CalciumNitride/Arabica37/README.md

# Arabica3/7

arabica3/7

A split keyboard with 3x6 column staggered keys, 1 pinkey and 3 thumb keys.

* Keyboard Maintainer: [CalciumNitride](https://github.com/CalciumNitride)
* Hardware Supported: Arabica3/7 PCB, Pro Micro
