CalciumNitride/Arabica37/firmware/arabica37/readme.md

# Arabica3/7

arabica3/7

A split keyboard with 3x6 column staggered keys, 1 pinkey and 3 thumb keys.

* Keyboard Maintainer: [CalciumNitride](https://github.com/CalciumNitride)
* Hardware Supported: Arabica3/7 PCB, Pro Micro
* Hardware Availability: [PCB & Case Data](https://github.com/calciumnitride/arabica37)

Make example for this keyboard (after setting up your build environment):

    make arabica37/rev1:default

See the [build environment setup](https://docs.qmk.fm/#/getting_started_build_tools) and the [make instructions](https://docs.qmk.fm/#/getting_started_make_guide) for more information. Brand new to QMK? Start with our [Complete Newbs Guide](https://docs.qmk.fm/#/newbs).
