CalciumNitride/Arabica37/pictures/1_diode01.png

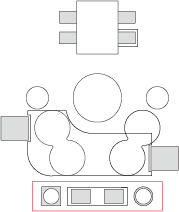
pictures/1_diode01.png
