CalciumNitride/Arabica37/pictures/2_backlightLED01.png

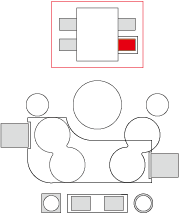
pictures/2_backlightLED01.png
