CalciumNitride/Arabica37/pictures/3_OLED01.png

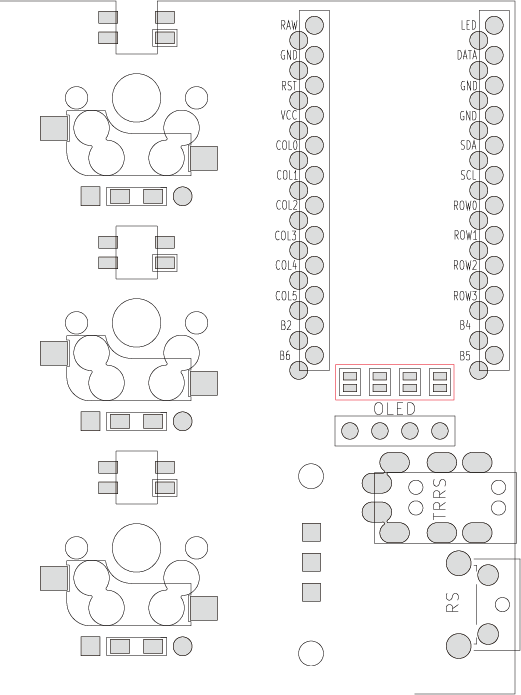
pictures/3_OLED01.png
