CalciumNitride/Arabica37/pictures/4_TRRSandRS01.png

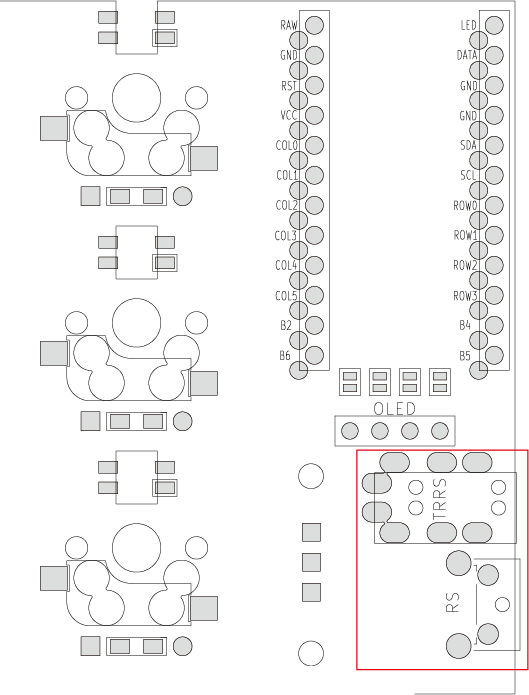
pictures/4_TRRSandRS01.png
