CalciumNitride/Arabica37/pictures/5_promicro01.png

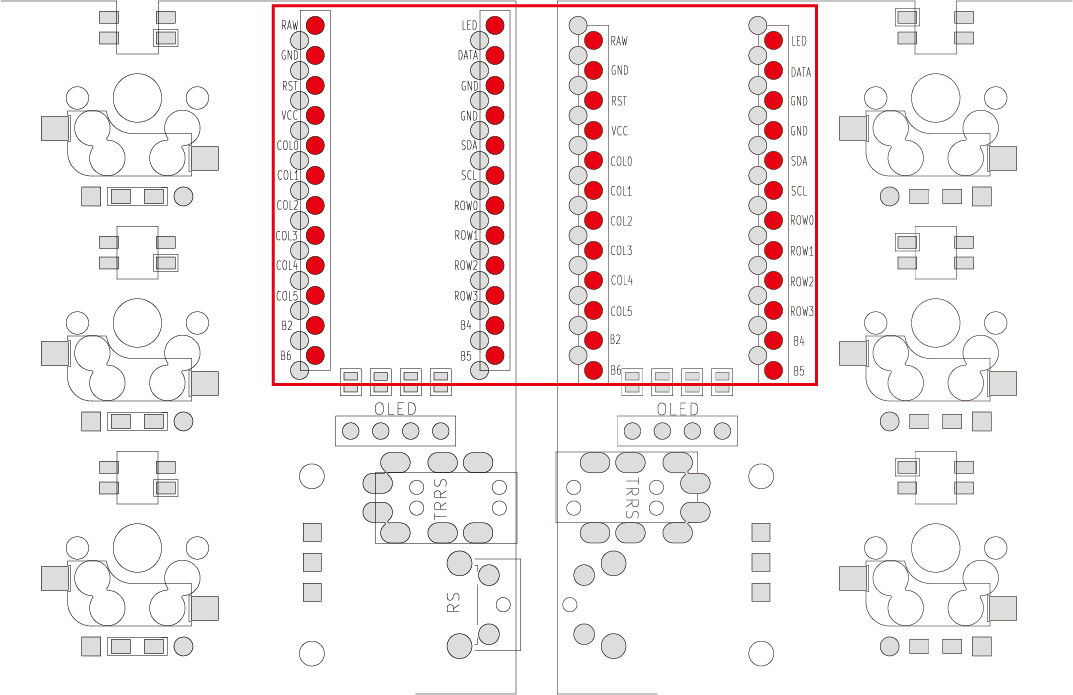
pictures/5_promicro01.png
