CalciumNitride/Arabica37/pictures/6_socket01.png

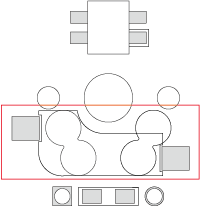
pictures/6_socket01.png
