CalciumNitride/Arabica37/pictures/8_LEDtest01.png

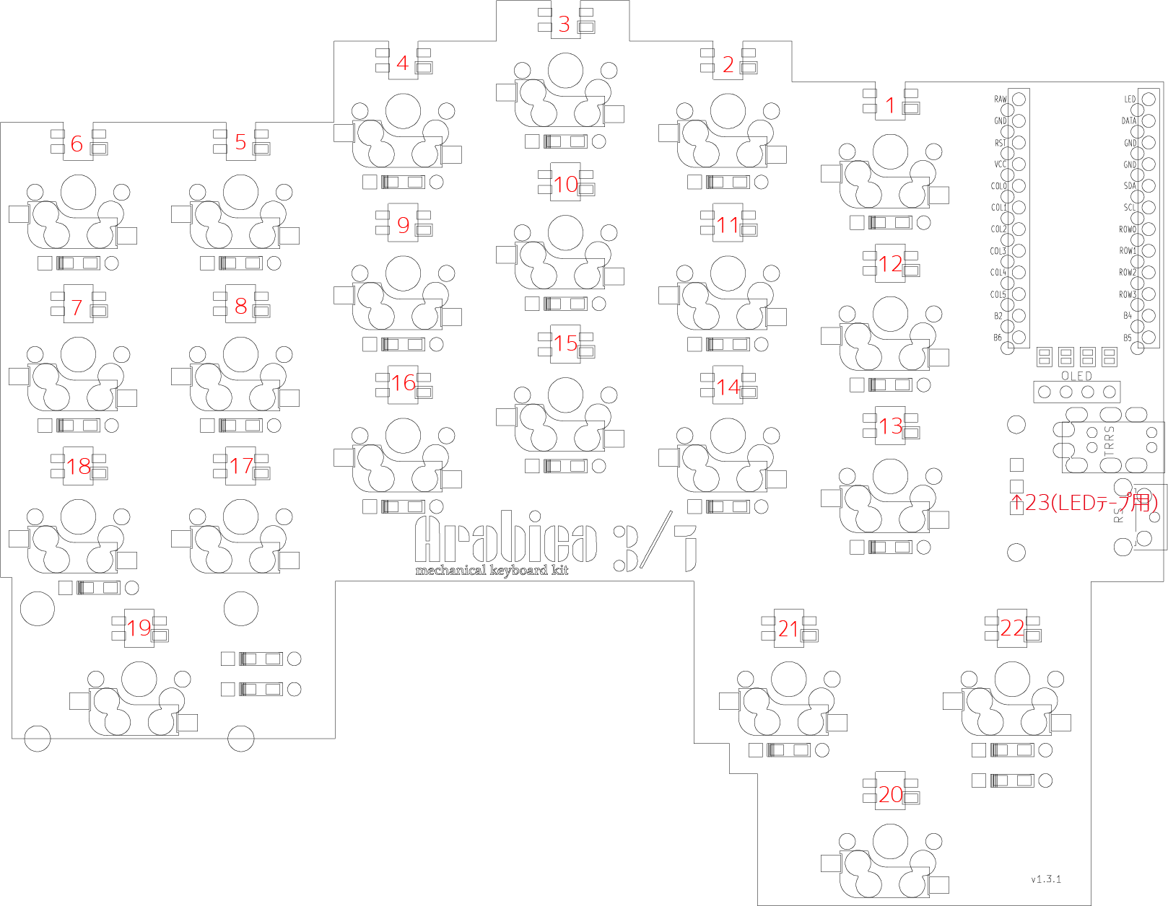
pictures/8_LEDtest01.png
