CalciumNitride/Arabica37/pictures/9_stabilizer01.png

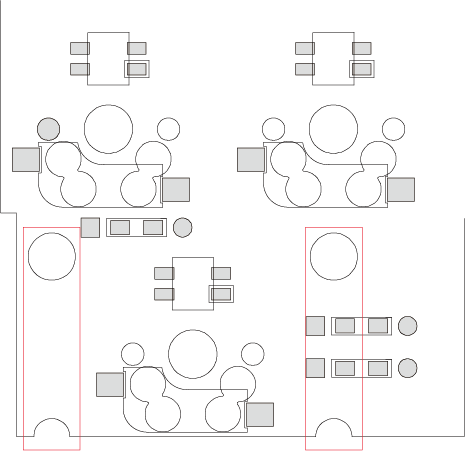
pictures/9_stabilizer01.png
