CalciumNitride/Arabica37/doc/v1.2buildguide.md

# build guide
自作キーボードキット Arabica3/7 v1.2基板のビルドガイドです。
現在遊舎工房で販売されているキットはv1.3.1ですので[こちら](https://qiita.com/CalciumNitride/items/0a86957d5b24e8304b73)をご覧ください。

## Parts

### キット内容物

名称| 数量 | 備考 |
----|----:|:----:|
PCB             |　2 | リバーシブル
スイッチプレート  | 2|"
ボトムプレート   | 2|"
Promicroカバー|2|"
TRRSジャック     |2|
タクトスイッチ    |2|リセットスイッチ用
スペーサ M2 8mm   |18|
ネジ M2          |36|
ダイオード       |44|スルーホール

### 別途用意する必要のあるもの

名称| 数量 | 備考 |
----|----:|:----:|
キースイッチ|44|MX互換
Kailh PCBソケット|44|キースイッチに合うもの
キーキャップ  |44|キースイッチに合うもの
ProMicro|2|コンスルー使用可
スタビライザー|2|小指キー用 2U
USBケーブル|1|
TRRSケーブル|1|

### オプション
名称| 数量 | 備考 |
----|----:|:----:|
ダイオード(チップ)|44|1N4148Wに対応
デジタルLEDテープ|2|Underglow用
配線材|3|Underglow LED用
OLEDモジュール|2|
4pinピンヘッダ|2|OLED用
4pinピンソケット|2|OLED用  

## 組み立て

PCBはリバーシブルです。どちらを左/右にしてもかまいません  
基本的に左右の実装は同じですが、Pro microの位置は間違え安いので注意してください

### 1.ダイオードを半田付けする

PCBの裏面にダイオードを半田付けします。
ダイオードの足を折り曲げ、PCBに差し込みます。このとき、ダイオードの黒い印がある側(マイナス)がPCB上の四角いパッドに来るようにします。



diode01

ひっくり返して半田付けします。

diode02

飛び出している足をニッパーで切ります。

diode03

※SMDのダイオードを使用する場合は[Corneのビルドガイド](https://github.com/foostan/crkbd/blob/master/corne-cherry/doc/buildguide_jp.md#ダイオード)等を参考にしてください。

### 2.OLEDモジュール用ジャンパ(オプション)

OLEDモジュールを使用する場合はPCBの __表側のみ__ 図のようにジャンパします



### 3.PCBソケットを半田付けする

PCBソケットをPCBの裏側に実装します。
ソケットは下がMX互換用です。

まず、パッドにはんだを盛ります。
socket01

次に、ソケットを載せ、側面からこて先をあてがって盛ったはんだを溶かし取り付けます。このとき、ソケットが浮かないようにピンセット等で押さえながら作業する必要があります。

socket02

### 4.OLEDモジュール用ピンソケットを半田付けする(オプション)

ピンソケットをPCBの表側に半田付けします(OLEDを利用する場合のみ)



### 5.タクトスイッチ、TRRSジャックを半田付けする

TRRSジャック、タクトスイッチはPCBの表側に実装します。



### 6. ProMicroを実装する

ProMicro用ピンヘッダをPCBの表側に半田付けし、その上にProMicroを裏面(平たい方)を上にして半田付けします

※このとき、ピンヘッダをPCB上の白い枠に合わせて実装します。正しく取り付けられて入ればPCB上の"RAW"とProMicroの"RAW"が同じ位置(左上)になります。
※コンスルーを使用する場合は[Helixのビルドガイド](https://github.com/MakotoKurauchi/helix/blob/master/Doc/buildguide_jp.md#pro-micro)等を参考にしてください 





飛び出した足はニッパーで切り取ります。

### 7. OLEDモジュールを実装する(オプション)

OLEDモジュール用ピンヘッダをピンソケットに差し込みます。さらにその上にOLEDモジュールを載せ、ピンヘッダとOLEDモジュールを半田付けします。
Promicroカバーとの干渉を防ぐため飛び出した足を切り取る必要があります。


　　　　　　　　　　　　　　　　　　　　　　　　　
### 8. Promicroカバー用スペーサーを取り付ける

ProMicro付近の穴にスペーサーを後ろからネジ止めします。



### 9. スタビライザーをはめ込む

2Uキー用のスタビライザーをPCBにはめ込みます。プレートマウントのスタビライザーを使う場合はプレート側にはめ込みます。

※現行のv1.2基板ではPCBマウントタイプのスタビライザーがスペーサーと干渉します。PCBマウントのスタビライザーを使う場合はスイッチプレートを6箇所で固定してください。



### 10. プレートにスイッチをはめ込む

スイッチプレートにスイッチをはめ込みます。はじめに角の2箇所のみをはめます。(スイッチが抜けないようプレートは固めに設計されています。どうしてもスイッチが入らない場合は穴の側面を削ってください)



### 11. プレートとPCBを合わせる

スイッチの足がPCBソケットにささるようにスイッチプレートとPCBを合わせます。



### 12. スイッチをはめ込む

残りのスイッチをはめ込みます。



このとき、スイッチの足が曲がっているとソケットに刺さらず、折れてしまうので注意してください。



### 13. Promicroカバーを取り付ける

Promicroカバーを取り付けます。Promicroカバー用のマイナスネジを使います。



### 14. ボトムプレートとスイッチプレートを合わせる

ボトムプレートにスペーサーを取り付けます。



スイッチプレートをボトムプレートに乗せてネジ止めします。



### 15. キーキャップを取り付ける

キーキャップをはめます。



お好みで[台座](https://github.com/CalciumNitride/Arabica37/tree/master/pedestal)やゴム足などをつけてチルト・安定化してください。



## ファームウェア

[こちら](https://docs.qmk.fm/#/newbs_getting_started)を参考にしてファームウェアを書き込むための環境を用意します。

QMK Firmwareのフォルダを開き、

```
make arabica37:default:avrdude
```

でビルド、書き込みを行います。

```
Detecting USB port, reset your controller now...
```

という表示が出たらキーボードのリセットボタンを押します。ProMicroの種類によっては二度押しもしくは長押しする必要があるものもあります。

```
avrdude.exe done.  Thank you.
```

と出たら書き込み完了です。同様にしてもう片手側にも書き込みます
