CalciumNitride/Arabica37/(threads)

Thread 1 (2020-05-17):

The Pro Micro cover design file is missing from plate_data

gorbachev, 2020-05-17:
Looks like the Pro Micro cover CAD design file is missing from the repo.

CalciumNitride, 2020-05-19:
@gorbachev
Thank you for pointing it out. I added it.

Closed 2020-05-19.
