CalciumNitride/Arabica37/firmware/arabica37/keymaps/jp_colemak/config.h

/*
This is the c configuration file for the keymap

Copyright 2012 Jun Wako <wakojun@gmail.com>
Copyright 2015 Jack Humbert

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
You should have received a copy of the GNU General Public License
along with this program.  If not, see <http://www.gnu.org/licenses/>.
*/

#pragma once

//#define USE_MATRIX_I2C

/* Select hand configuration */

#define MASTER_LEFT
// #define MASTER_RIGHT
// #define EE_HANDS

#define TAPPING_FORCE_HOLD
#define TAPPING_TERM 165

#undef RGBLED_NUM
#define RGBLIGHT_ANIMATIONS
#define RGBLED_NUM 50
#define RGBLIGHT_LIMIT_VAL 235
#define RGBLIGHT_HUE_STEP 10
#define RGBLIGHT_SAT_STEP 17
#define RGBLIGHT_VAL_STEP 17

#define OLED_FONT_H "keyboards/arabica37/lib/glcdfont_yorumi.c"
