CalciumNitride/Arabica37/(commit log)

2020-05-17 organize files
    [Arabica37_switch.kicad_pcb, Arabica37_switch.sch]
2020-05-19 organize plate_data files and add 'ProMicro-cover.ai'
    [Arabica37_switch.kicad_pcb, Arabica37_switch.sch, arabica37.dsn, arabica37_bottom.kicad_pcb]
